CyberspiceHardware/ElectronUserPort/Images/ElectronUserPortCartridge.jpg

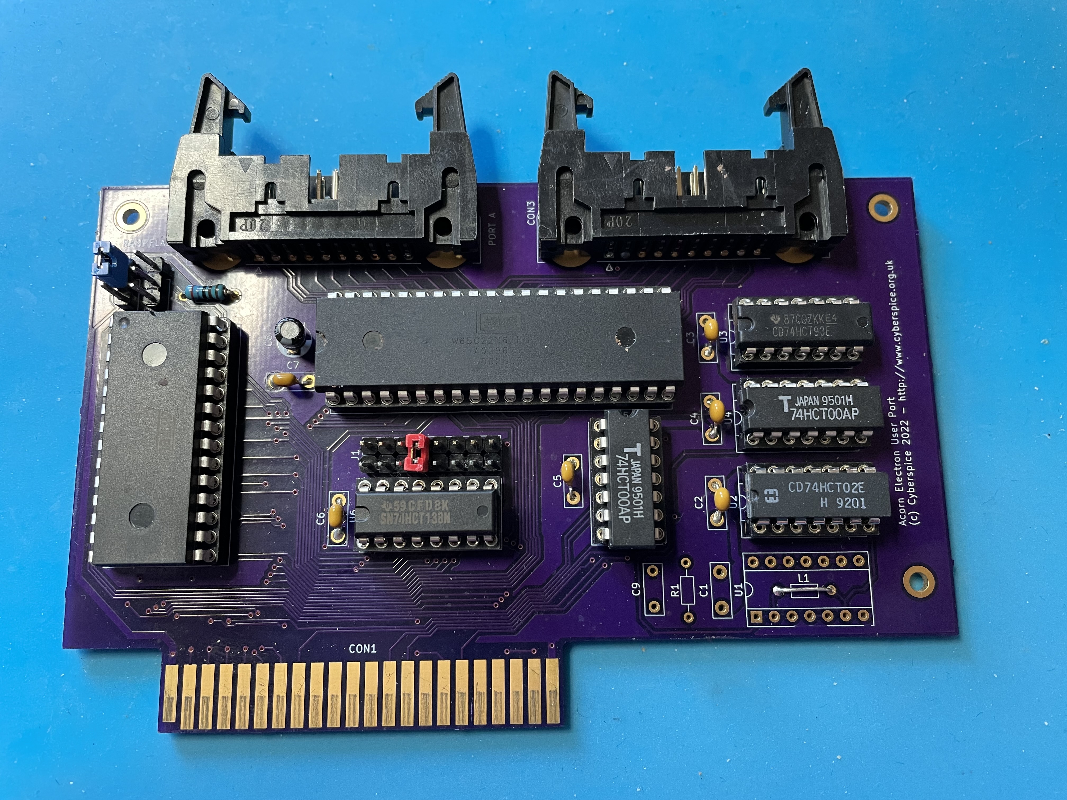
Images/ElectronUserPortCartridge.jpg
