CyberspiceHardware/ElectronUserPort/README.md

# Acorn Electron User Port Cartridge 

This is a BBC micro compatible user port cartridge which can be configured
to sit at any of the 16 byte addresses spaces 0xFC80 and above. The standard
address is 0xFCB0.

It also supports a ROM/RAM/FLASH device which can be a 16KB or 32KB part.
