CyberspiceHardware/ElectronUserPort/KiCad/ElectronUserPortCartridge.kicad_pcb

## KiCad design KiCad/ElectronUserPortCartridge.kicad_pcb (2022-06-01)

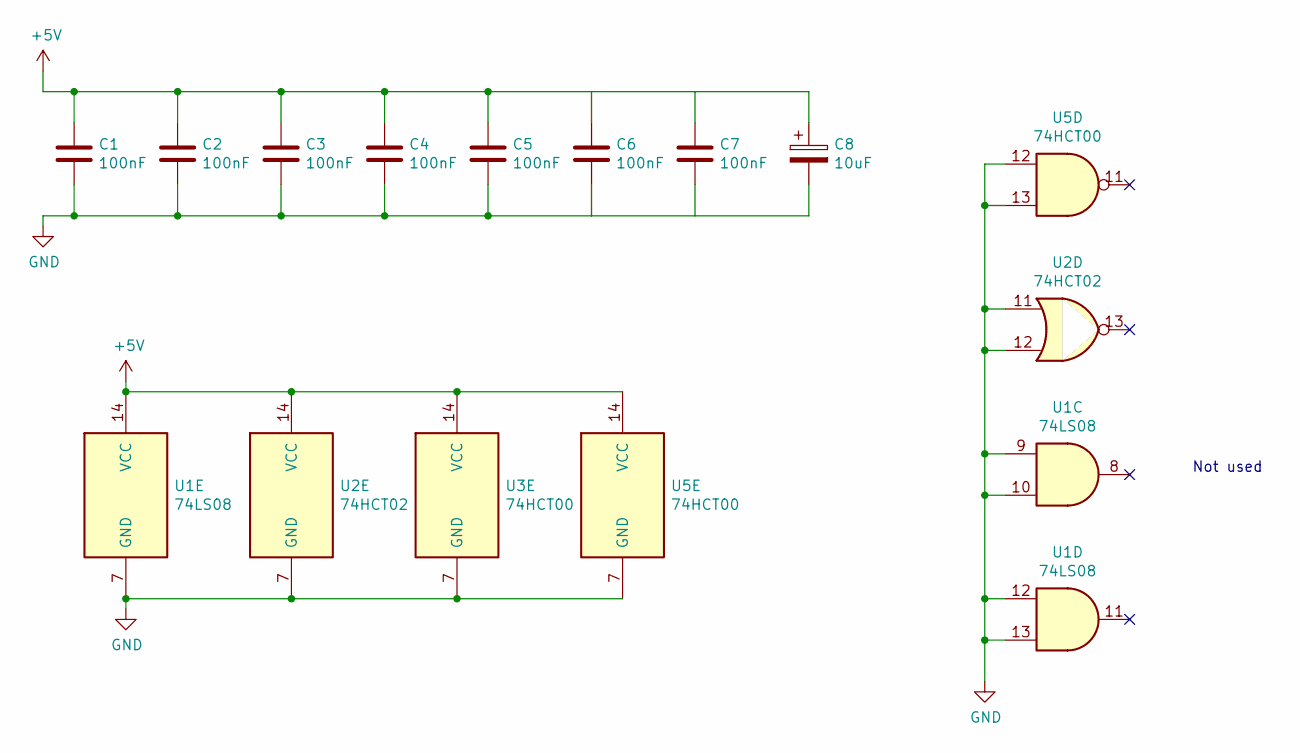
[picture p6: schematic Power.sch, Electron User Port Cartridge - Power]

Parts:
C1, C2, C3, C4, C5, C6, C7: 100nF; C_Disc_D7.5mm_W2.5mm_P5.00mm
C8: 10uF; CP_Radial_D5.0mm_P2.50mm
U1: 74LS08
U2: 74HCT02
U3: 74HCT00
U5: 74HCT00; DIP-14_W7.62mm_Socket

Connections:
+5V: C1.1, C2.1, C3.1, C4.1, C5.1, C6.1, C7.1, C8.1, U1.14 (VCC), U2.14 (VCC), U3.14 (VCC), U5.14 (VCC); also elsewhere on the board
GND: C1.2, C2.2, C3.2, C4.2, C5.2, C6.2, C7.2, C8.2, U1.7 (GND), U1.9, U1.10, U1.12, U1.13, U2.7 (GND), U2.11, U2.12, U3.7 (GND), U5.7 (GND), U5.12, U5.13; also elsewhere on the board

Notes on the sheet:
Not used

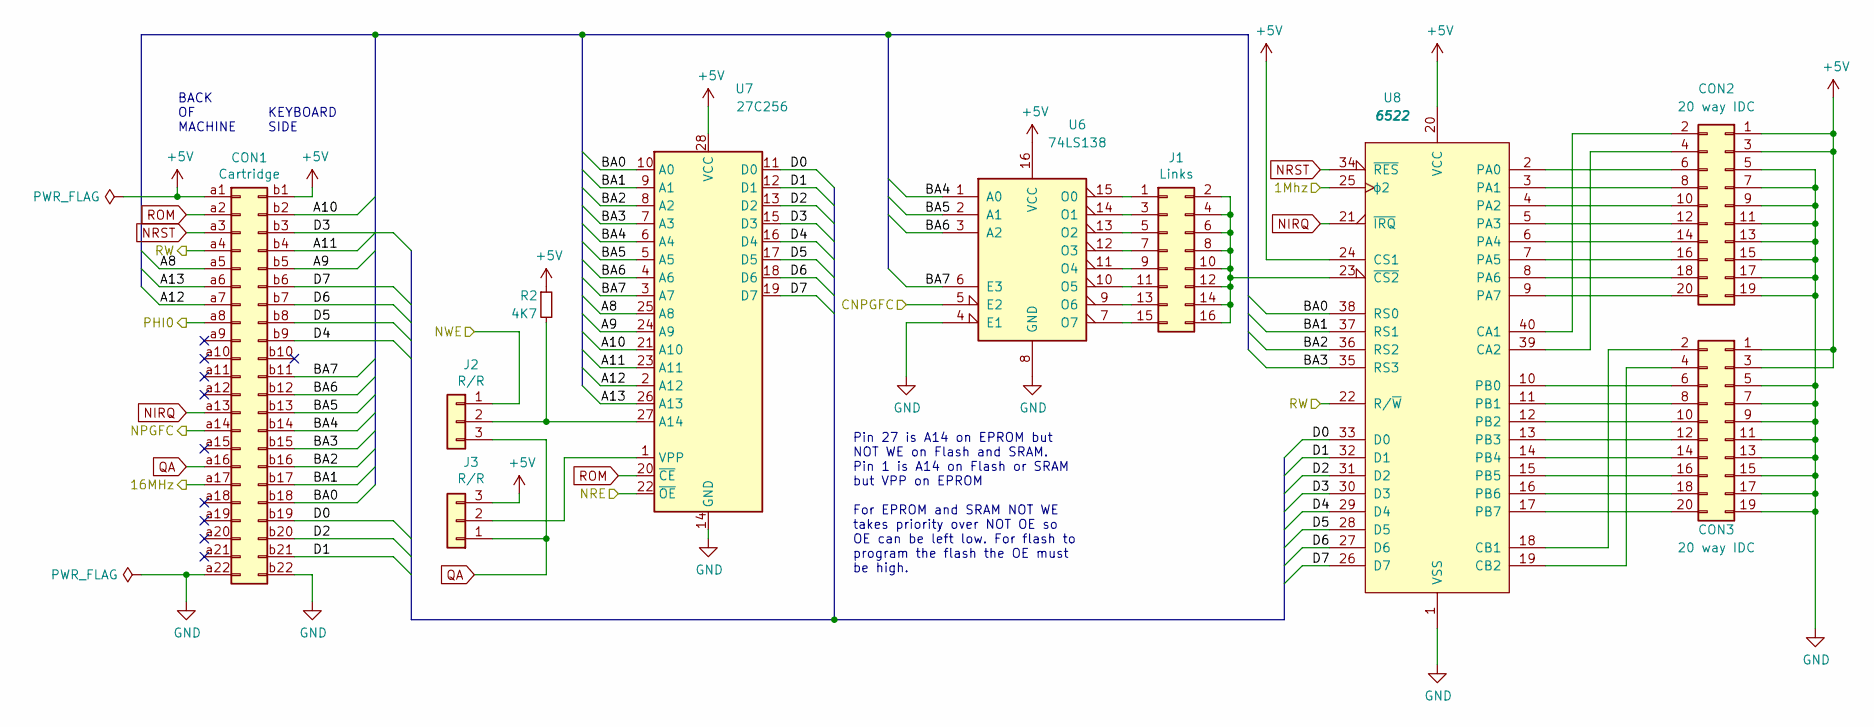
[picture p7: schematic RAMandIO.sch, Electron User Port Cartridge - Memory and IO]

Parts:
CON1: Cartridge; ElectronCartridgeEdge
CON2, CON3: 20 way IDC; IDC-Header_2x10-1MP_P2.54mm_Latch_Horizontal
J1: Links; PinHeader_2x08_P2.54mm_Vertical
J2, J3: R/R; PinHeader_1x03_P2.54mm_Vertical
R2: 4K7; R_Axial_DIN0207_L6.3mm_D2.5mm_P7.62mm_Horizontal
U6: 74LS138; DIP-16_W7.62mm_Socket
U7: 27C256; DIP-28_W15.24mm_Socket
U8: 6522; DIP-40_W15.24mm_Socket

Connections:
+5V: CON1.a1, CON1.b1, CON2.1, CON2.3, CON3.1, CON3.3, J3.3, R2.1, U6.16 (VCC), U7.28 (VCC), U8.20 (VCC), U8.24 (CS1); also elsewhere on the board
/ClocksAndSignals/1Mhz: U8.25 (ϕ2); also elsewhere on the board
/ClocksAndSignals/CNPGFC: U6.5 (E2); also elsewhere on the board
/ClocksAndSignals/NPGFC: CON1.a14; also elsewhere on the board
/ClocksAndSignals/NRE: U7.22 (~OE); also elsewhere on the board
/ClocksAndSignals/NWE: J2.1; also elsewhere on the board
/ClocksAndSignals/PHI0: CON1.a8; also elsewhere on the board
/ClocksAndSignals/RW: CON1.a4, U8.22 (R/~W); also elsewhere on the board
/RAMandIO/16MHz: CON1.a17; also elsewhere on the board
/RAMandIO/A8: CON1.a5, U7.25 (A8)
/RAMandIO/A9: CON1.b5, U7.24 (A9)
/RAMandIO/A10: CON1.b2, U7.21 (A10)
/RAMandIO/A11: CON1.b4, U7.23 (A11)
/RAMandIO/A12: CON1.a7, U7.2 (A12)
/RAMandIO/A13: CON1.a6, U7.26 (A13)
/RAMandIO/BA0: CON1.b18, U7.10 (A0), U8.38 (RS0)
/RAMandIO/BA1: CON1.b17, U7.9 (A1), U8.37 (RS1)
/RAMandIO/BA2: CON1.b16, U7.8 (A2), U8.36 (RS2)
/RAMandIO/BA3: CON1.b15, U7.7 (A3), U8.35 (RS3)
/RAMandIO/BA4: CON1.b14, U6.1 (A0), U7.6 (A4)
/RAMandIO/BA5: CON1.b13, U6.2 (A1), U7.5 (A5)
/RAMandIO/BA6: CON1.b12, U6.3 (A2), U7.4 (A6)
/RAMandIO/BA7: CON1.b11, U6.6 (E3), U7.3 (A7)
/RAMandIO/D0: CON1.b19, U7.11 (D0), U8.33 (D0)
/RAMandIO/D1: CON1.b21, U7.12 (D1), U8.32 (D1)
/RAMandIO/D2: CON1.b20, U7.13 (D2), U8.31 (D2)
/RAMandIO/D3: CON1.b3, U7.15 (D3), U8.30 (D3)
/RAMandIO/D4: CON1.b9, U7.16 (D4), U8.29 (D4)
/RAMandIO/D5: CON1.b8, U7.17 (D5), U8.28 (D5)
/RAMandIO/D6: CON1.b7, U7.18 (D6), U8.27 (D6)
/RAMandIO/D7: CON1.b6, U7.19 (D7), U8.26 (D7)
GND: CON1.a22, CON1.b22, CON2.5, CON2.7, CON2.9, CON2.11, CON2.13, CON2.15, CON2.17, CON2.19, CON3.5, CON3.7, CON3.9, CON3.11, CON3.13, CON3.15, CON3.17, CON3.19, U6.4 (E1), U6.8 (GND), U7.14 (GND), U8.1 (VSS); also elsewhere on the board
NIRQ: CON1.a13, U8.21 (~IRQ)
NRST: CON1.a3, U8.34 (~RES)
unnamed: CON2.2, U8.40 (CA1)
unnamed: CON2.4, U8.39 (CA2)
unnamed: CON2.6, U8.2 (PA0)
unnamed: CON2.8, U8.3 (PA1)
unnamed: CON2.10, U8.4 (PA2)
unnamed: CON2.12, U8.5 (PA3)
unnamed: CON2.14, U8.6 (PA4)
unnamed: CON2.16, U8.7 (PA5)
unnamed: CON2.18, U8.8 (PA6)
unnamed: CON2.20, U8.9 (PA7)
unnamed: CON3.2, U8.18 (CB1)
unnamed: CON3.4, U8.19 (CB2)
unnamed: CON3.6, U8.10 (PB0)
unnamed: CON3.8, U8.11 (PB1)
unnamed: CON3.10, U8.12 (PB2)
unnamed: CON3.12, U8.13 (PB3)
unnamed: CON3.14, U8.14 (PB4)
unnamed: CON3.16, U8.15 (PB5)
unnamed: CON3.18, U8.16 (PB6)
unnamed: CON3.20, U8.17 (PB7)
unnamed: J1.1, U6.15 (O0)
unnamed: J1.3, U6.14 (O1)
unnamed: J1.5, U6.13 (O2)
unnamed: J1.7, U6.12 (O3)
unnamed: J1.9, U6.11 (O4)
unnamed: J1.2, J1.4, J1.6, J1.8, J1.10, J1.12, J1.14, J1.16, U8.23 (~CS2)
unnamed: J1.11, U6.10 (O5)
unnamed: J1.13, U6.9 (O6)
unnamed: J1.15, U6.7 (O7)
unnamed: J2.2, R2.2, U7.27 (A14)
unnamed: J3.2, U7.1 (VPP)
QA: CON1.a16, J2.3, J3.1
ROM: CON1.a2, U7.20 (~CE)

Notes on the sheet:
BACK OF MACHINE
KEYBOARD SIDE
Pin 27 is A14 on EPROM but NOT WE on Flash and SRAM. Pin 1 is A14 on Flash or SRAM but VPP on EPROM For EPROM and SRAM NOT WE takes priority over NOT OE so OE can be left low. For flash to program the flash the OE must be high.

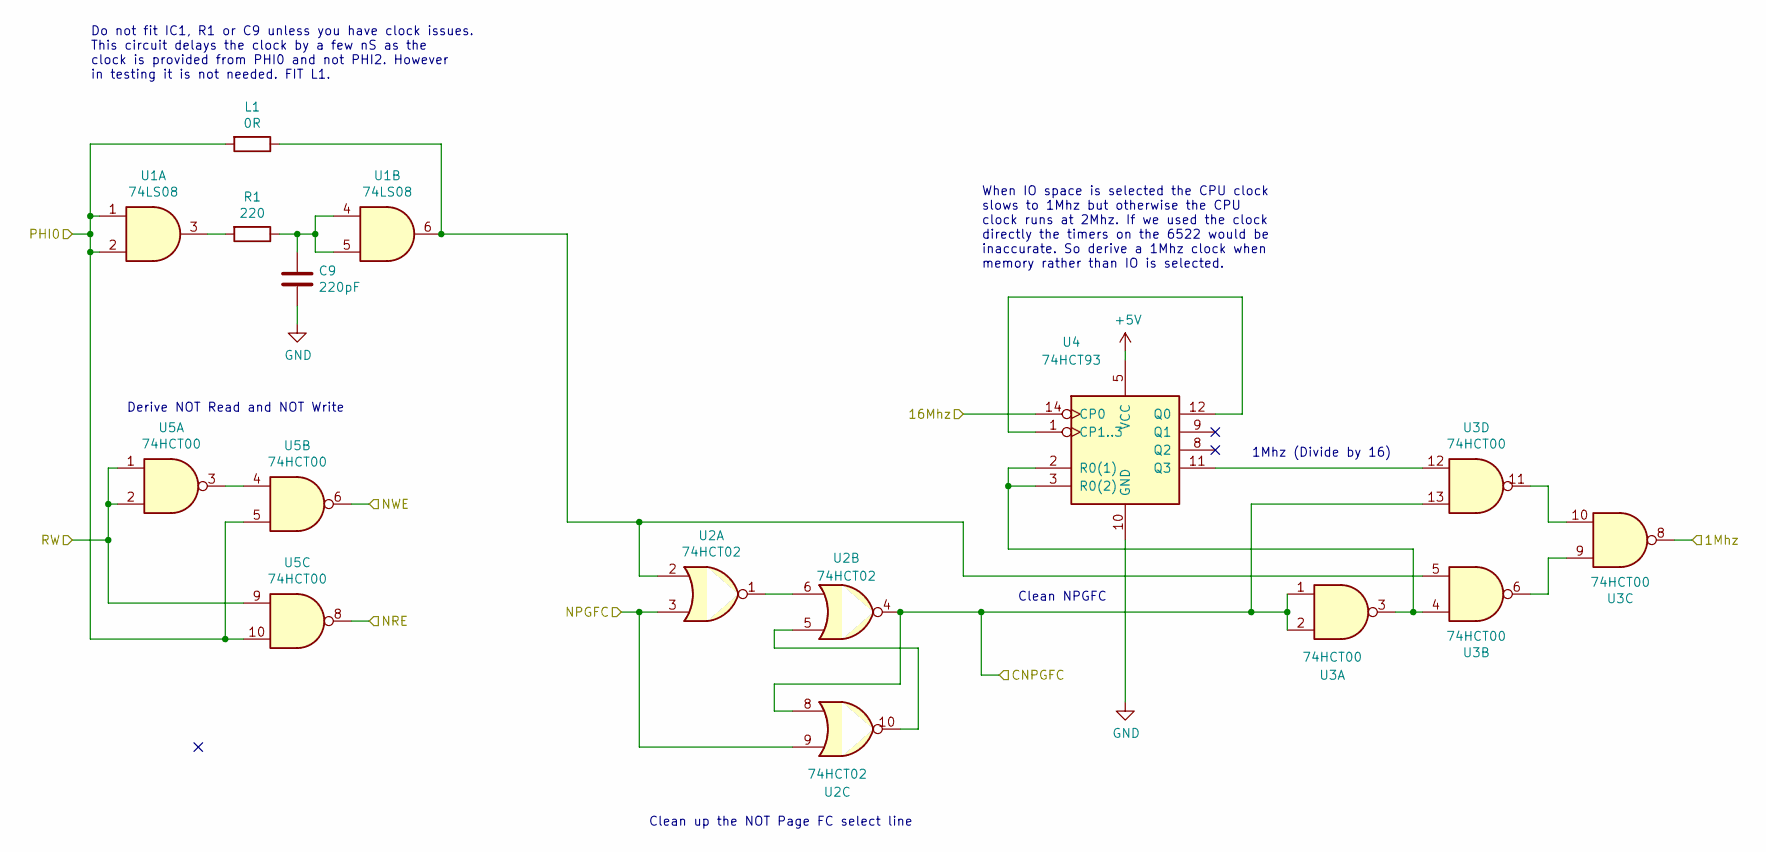
[picture p8: schematic ClocksAndSignals.sch, Electron User Port Cartridge - Clock and decode logic]

Parts:
C9: 220pF; C_Disc_D7.0mm_W2.5mm_P5.00mm
L1: 0R; R_Axial_DIN0204_L3.6mm_D1.6mm_P7.62mm_Horizontal
R1: 220; R_Axial_DIN0207_L6.3mm_D2.5mm_P7.62mm_Horizontal
U1: 74LS08; DIP-14_W7.62mm_Socket
U2: 74HCT02; DIP-14_W7.62mm_Socket
U3, U5: 74HCT00; DIP-14_W7.62mm_Socket
U4: 74HCT93; DIP-14_W7.62mm_Socket

Connections:
+5V: U4.5 (VCC); also elsewhere on the board
/ClocksAndSignals/1Mhz: U3.8; also elsewhere on the board
/ClocksAndSignals/CNPGFC: U2.4, U2.8, U3.1, U3.2, U3.13; also elsewhere on the board
/ClocksAndSignals/NPGFC: U2.3, U2.9; also elsewhere on the board
/ClocksAndSignals/NRE: U5.8; also elsewhere on the board
/ClocksAndSignals/NWE: U5.6; also elsewhere on the board
/ClocksAndSignals/PHI0: L1.2, U1.1, U1.2, U5.5, U5.10; also elsewhere on the board
/ClocksAndSignals/RW: U5.1, U5.2, U5.9; also elsewhere on the board
/RAMandIO/16MHz: U4.14 (CP0); also elsewhere on the board
GND: C9.2, U4.10 (GND); also elsewhere on the board
unnamed: C9.1, R1.1, U1.4, U1.5
unnamed: L1.1, U1.6, U2.2, U3.5
unnamed: R1.2, U1.3
unnamed: U2.1, U2.6
unnamed: U2.5, U2.10
unnamed: U3.3, U3.4, U4.2 (R0(1)), U4.3 (R0(2))
unnamed: U3.6, U3.9
unnamed: U3.10, U3.11
unnamed: U3.12, U4.11 (Q3)
unnamed: U4.1 (CP1..3), U4.12 (Q0)
unnamed: U5.3, U5.4

Notes on the sheet:
1Mhz (Divide by 16)
Clean NPGFC
Clean up the NOT Page FC select line
Derive NOT Read and NOT Write
When IO space is selected the CPU clock slows to 1Mhz but otherwise the CPU clock runs at 2Mhz. If we used the clock directly the timers on the 6522 would be inaccurate. So derive a 1Mhz clock when memory rather than IO is selected.
Do not fit IC1, R1 or C9 unless you have clock issues. This circuit delays the clock by a few nS as the clock is provided from PHI0 and not PHI2. However in testing it is not needed. FIT L1.

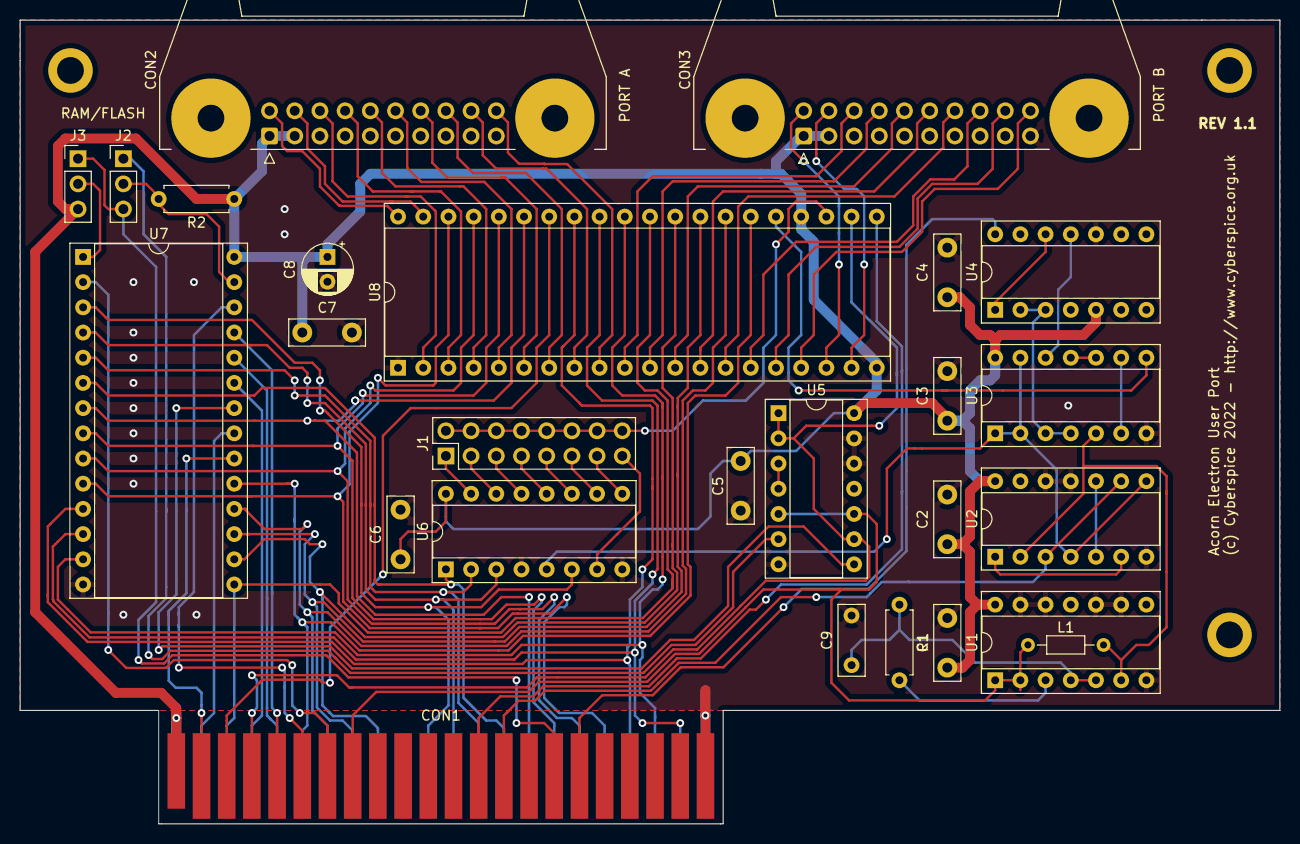
[picture p9: board ElectronUserPortCartridge.kicad_pcb from above]

Board: 2 copper layers, 127.0 x 81.0 mm, 29 parts (0 on the bottom side), 78 nets.

Other parts of the board:
hole1, hole2, hole3: MountingHole_2.7mm_M2.5_ISO7380_Pad
