CyberspiceHardware/ElectronUserPort/(commit log)

2022-03-01 Added schematic as a PDF and gerber files
    [ElectronUserPortCartridge-B_Cu.gbr, ElectronUserPortCartridge-B_Mask.gbr, ElectronUserPortCartridge-B_Paste.gbr, ElectronUserPortCartridge-B_SilkS.gbr, ElectronUserPortCartridge-Edge_Cuts.gbr, ElectronUserPortCartridge-F_Cu.gbr, ElectronUserPortCartridge-F_Mask.gbr, ElectronUserPortCartridge-F_Paste.gbr]
2022-06-01 Updates for fixes (Rev A2)
    [ClocksAndSignals.sch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]
